louisleeshinghim/delalomo/Fabrication files/billofmaterials.xlsx

Component type | Item | Model number | Footprint | Quantity | DigiKey Part Number | Hyperlink
Integrated circuit | Microcontroller | ATMEGA128A-AU | TQFP-64 | 1 | ATMEGA128A-AU-ND | https://www.digikey.hk/en/products/detail/microchip-technology/ATMEGA128A-AU/1886206
Integrated circuit | 8-channel I2C multiplexer | TCA9548APWR | TSSOP-24 | 1 | 296-34905-2-ND | https://www.digikey.hk/en/products/detail/texas-instruments/TCA9548APWR/3615458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
Integrated circuit | Real-time clock | DS3231SN#T&R | SOIC-16 | 1 | DS3231SN#T&RTR-ND | https://www.digikey.hk/en/products/detail/analog-devices-inc-maxim-integrated/DS3231SN-T-R/1197577
Integrated circuit | Quadruple bus buffer gate | SN74LVC125APWR | TSSOP14 | 1 | 296-1222-2-ND | https://www.digikey.hk/en/products/detail/texas-instruments/SN74LVC125APWR/276865
Integrated circuit | I2C accelerator | LTC4311CSC6#TRPBF | SC-70 | 1 | LTC4311CSC6#TRPBFTR-ND | https://www.digikey.hk/en/products/detail/analog-devices-inc/LTC4311CSC6-TRPBF/1814490
Integrated circuit | 16-bit analog-digital converter | ADS1115IDGSR | VSSOP-10 | 1 | 296-38849-2-ND | https://www.digikey.hk/en/products/detail/texas-instruments/ADS1115IDGSR/2231567
Integrated circuit | 10-volt Zener diode | ZM4740A-GS08 | LL-34 | 1 | ZM4740A-GS08TR-ND | https://www.digikey.hk/en/products/detail/vishay-general-semiconductor-diodes-division/ZM4740A-GS08/3104286
Integrated circuit | Logic-level, P-channel MOSFET | AO3401A | SOT-23 | 2 | 785-1001-2-ND | https://www.digikey.hk/en/products/detail/alpha-omega-semiconductor-inc/AO3401A/1855773
Voltage regulator | 3.3-volt regulator | AMS1117-3.3 | SOT-223 | 1 | 5272-AMS1117-3.3TR-ND | https://www.digikey.hk/en/products/detail/evvo/AMS1117-3-3/22482148
Voltage regulator | 5.0-volt regulator | MCP1702T-5002E/CB | SOT-23 | 1 | MCP1702T-5002E/CBTR-ND | https://www.digikey.hk/en/products/detail/microchip-technology/MCP1702T-5002E-CB/1098473
Resistor | 470 Ω | RC1206JR-07470RL | 1206 | 1 | 311-470ERTR-ND | https://www.digikey.hk/en/products/detail/yageo/RC1206JR-07470RL/729301
Resistor | 3.3 KΩ | RC1206JR-073K3L | 1206 | 3 | 311-3.3KERTR-ND | https://www.digikey.hk/en/products/detail/yageo/RC1206JR-073K3L/729267
Resistor | 4.7 KΩ | RC1206JR-074K7L | 1206 | 2 | 311-4.7KERTR-ND | https://www.digikey.hk/en/products/detail/yageo/RC1206JR-074K7L/729295
Resistor | 10 KΩ | RC1206JR-0710KL | 1206 | 5 | 311-10KERTR-ND | https://www.digikey.hk/en/products/detail/yageo/rc1206jr-0710kl/729209
Resistor | 47 KΩ | RC1206JR-0747KL | 1206 | 1 | 311-47KERTR-ND | https://www.digikey.hk/en/products/detail/yageo/RC1206JR-0747KL/729303
Resistor | 100 KΩ | RC1206JR-07100KL | 1206 | 1 | 311-100KERTR-ND | https://www.digikey.hk/en/products/detail/yageo/RC1206JR-07100KL/729207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
Resistor | 1 MΩ | RC1206JR-071ML | 1206 | 1 | 311-1.0MERTR-ND | https://www.digikey.hk/en/products/detail/yageo/rc1206jr-071ml/729187
Capacitor | 22 pF | CC1206JRNPO9BN220 | 1206 | 2 | 311-1154-2-ND | https://www.digikey.hk/en/products/detail/yageo/CC1206JRNPO9BN220/302888
Capacitor | 0.1 μF | C1206C104K5RACTU | 1206 | 14 | 399-C1206C104K5RACTUCT-ND | https://www.digikey.hk/en/products/detail/kemet/C1206C104K5RACTU/411248
Capacitor | 10 μF | CC1206ZKY5V7BB106 | 1206 | 5 | 311-1376-2-ND | https://www.digikey.hk/en/products/detail/yageo/CC1206ZKY5V7BB106/2103114
Crystal oscillator | 16 MHz crystal | ATS16A | Through-hole | 1 | CTX415-ND | https://www.digikey.hk/en/products/detail/cts-frequency-controls/ATS16A/280195
LED | 5 mm LED | LTL-4233 | Through-hole | 1 | 160-1130-ND | https://www.digikey.hk/en/products/detail/liteon/LTL-4233/217580
Momentary switch | 6 mm × 6 mm, SPST tactile switch | 1825910-6 | Through-hole | 1 | 450-1650-ND | https://www.digikey.hk/en/products/detail/te-connectivity-alcoswitch-switches/1825910-6/1632536
MicroSD card socket | Push-in, eject-out MicroSD holder | MSD-4-A | N/A | 1 | 2223-MSD-4-ATR-ND | https://www.digikey.hk/en/products/detail/same-sky-formerly-cui-devices/MSD-4-A/21796808
Battery holder | Vertical, CR2032-type holder | 1074 | N/A | 1 | 36-1074-ND | https://www.digikey.hk/en/products/detail/keystone-electronics/1074/9921784
Battery holder | Dual, 18650-type holder | 114090053 | N/A | 1 | 1597-114090053-ND | https://www.digikey.hk/en/products/detail/seeed-technology-co-ltd/114090053/10451921
3.81-mm-pitch terminal block | 2-position, shrouded male header | 691321300002 | N/A | 1 | 732-2082-ND | https://www.digikey.hk/en/products/detail/w%C3%BCrth-elektronik/691321300002/2060578
3.81-mm-pitch terminal block | 3-position, shrouded male header | 691321300003 | N/A | 7 | 732-2083-ND | https://www.digikey.hk/en/products/detail/w%C3%BCrth-elektronik/691321300003/2060579
3.81-mm-pitch terminal block | 4-position, shrouded male header | 691321300004 | N/A | 11 | 732-2084-ND | https://www.digikey.hk/en/products/detail/w%C3%BCrth-elektronik/691321300004/2060580
2.54-mm-pitch pin header | 3-position, 1-row straight male | TS-103-T-A | N/A | 1 | SAM1112-03-ND | https://www.digikey.hk/en/products/detail/samtec-inc/TS-103-T-A/1105491
2.54-mm-pitch pin header | 6-position, 1-row angled male | PH1RA-06-UA | N/A | 1 | 2057-PH1RA-06-UA-ND | https://www.digikey.hk/en/products/detail/adam-tech/PH1RA-06-UA/9830540
2.54-mm-pitch pin connector | 2-position, 1-row female socket | RS1-02-G | N/A | 2 | RS1-02-G | https://www.digikey.hk/en/products/detail/adam-tech/RS1-02-G/9832044
2.54-mm-pitch pin connector | 6-position, 1-row female socket | M20-7820642 | N/A | 1 | 952-1808-ND | https://www.digikey.hk/en/products/detail/harwin-inc/M20-7820642/3727776
2.54-mm-pitch pin connector | 6-position, 2-row female socket | PPPC032LFBN-RC | N/A | 1 | S7106-ND | https://www.digikey.hk/en/products/detail/sullins-connector-solutions/PPPC032LFBN-RC/810243
Wire | 20-AWG, 2-conductor cable | 30-00416 | N/A | 1 | T3016-305-ND | https://www.digikey.hk/en/products/detail/tensility-international-corp/30-00416/6026140
Printed circuit board | Custom-made board | See Gerber file | N/A | 1 | N/A | https://jlcpcb.com/
ABS enclosure | 250 mm x 75 mm x 80 mm, IP65 box | XL-KT 250*80*70MM | N/A | 1 | N/A | https://www.alibaba.com/product-detail/250-80-70MM-Rectangular-Shape-IP66-60402470299.html
Velcro | Self-adhesive, hook-and-loop fastener | HHB-0B | N/A | 1 | N/A | https://www.alibaba.com/product-detail/High-Quality-Nylon-Hook-and-Loop_60562132548.html
Slotted screw | M4 × 0.8, pan-head | 50M040070N008 | N/A | 2 | 145-50M040070N008-ND | https://www.digikey.hk/en/products/detail/essentra-components/50M040070N008/11639633
Plastic washer | M4 × 0.8, flat | 16M04090080 | N/A | 4 | RPC10430-ND | https://www.digikey.hk/en/products/detail/essentra-components/16M04090080/10299326
