louisleeshinghim/delalomo/(commit log)

2025-04-04 Add files via upload
    Upload the schematic of DE-LA-LO-MO
2025-04-04 Add files via upload
    Upload the PCB layout of DE-LA-LO-MO
2025-04-04 Add files via upload
    Upload the Gerber file of DE-LA-LO-MO
2025-04-04 Gerber file of DE-LA-LO-MO
2025-04-04 PCB layout of DE-LA-LO-MO
2025-04-04 Schematic of DE-LA-LO-MO
2025-04-04 Schematic of breakout board
2025-04-04 Gerber file of breakout board
2025-04-04 PCB layout of breakout board
2025-04-07 Bill of materials
    Bill of materials
    [billofmaterials.xlsx]
2025-04-08 I2C tester
2025-04-08 RTC setter - Arduino sketch
2025-04-08 I2C tester - Arduino sketch
2025-04-08 I2C scanner - Arduino sketch
